kurrosetra/FDI/PCB/LRT_arduino_v2a.brd

## EAGLE design PCB/LRT_arduino_v2a.brd (2020-02-21)

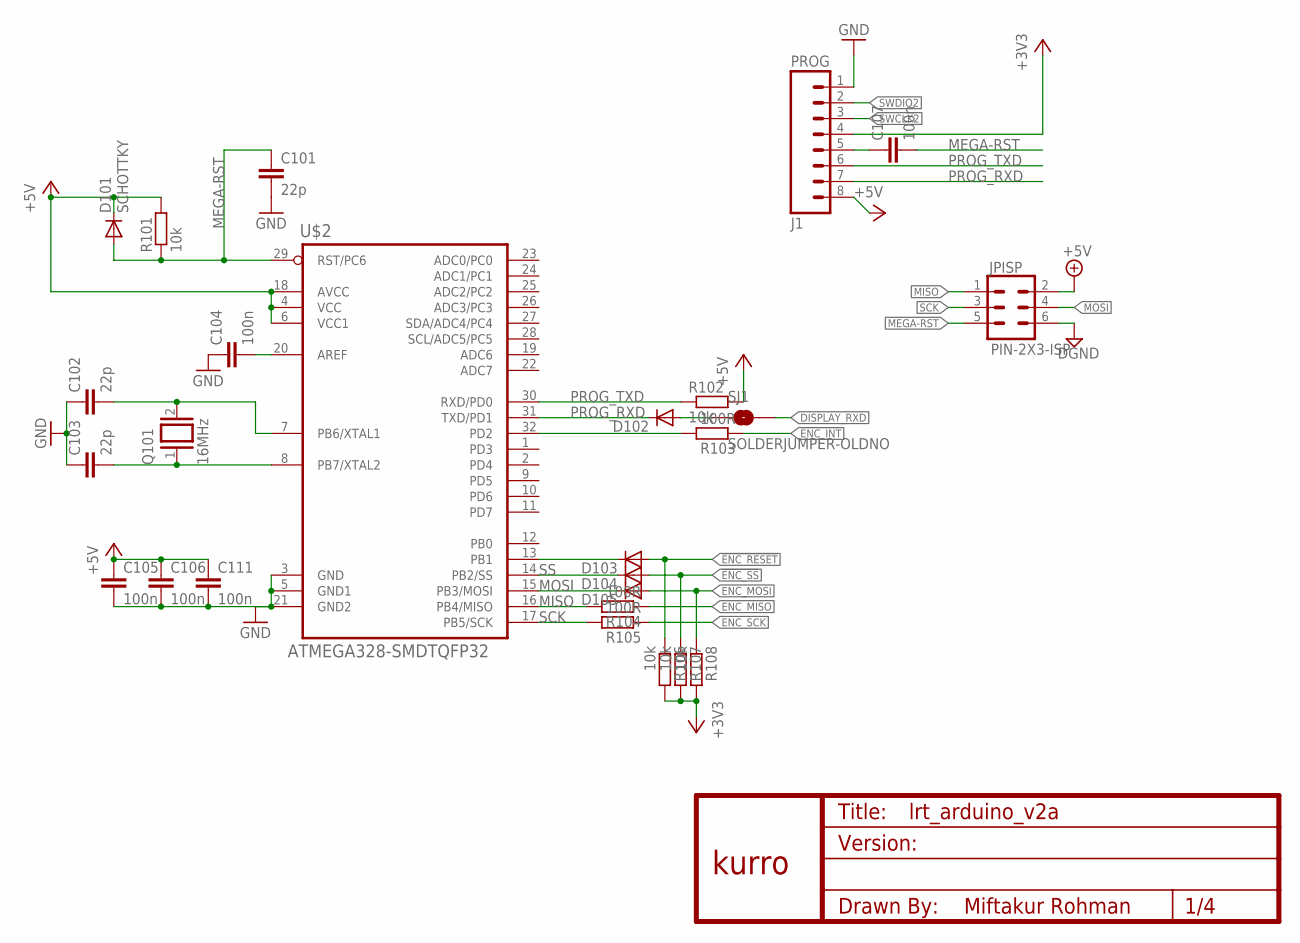
[picture p1: schematic LRT_arduino_v2a.sch, sheet 1, MAIN CONTROLLER]

Parts:
C101, C102, C103: 22p; C0603
C104, C105, C106, C107, C111: 100n; C0603
D101: SCHOTTKY; MICROMELF-W
D102, D103, D104, D105: DIODE-MICROMELF-W; MICROMELF-W
J1: PROG; XH-8-RA
JPISP: PIN-2X3-ISP; 2X03
Q101: 16MHz; QS
R101, R102, R106, R107, R108: 10k; R0603
R103, R104, R105: 100R; R0603
SJ1: SOLDERJUMPER-OLDNO; SJ_2S-NO
U$1: KURRO_FOOTPRINT; KURRO-LOGO
U$2: ATMEGA328-SMDTQFP32; TQFP32

Connections:
!ENC_INT: R103.1; also elsewhere on the board
!ENC_RESET: D103.A, R106.1; also elsewhere on the board
!ENC_SS: D104.A, R107.1; also elsewhere on the board
+3V3: J1.4, R106.2, R107.2, R108.2; also elsewhere on the board
+5V: C105.1, C106.1, C111.1, D101.C, J1.8, JPISP.2, R101.2, R102.2, U$2.4 (VCC), U$2.6 (VCC1), U$2.18 (AVCC); also elsewhere on the board
DISPLAY_RXD: SJ1.2; also elsewhere on the board
ENC_MISO: R104.1; also elsewhere on the board
ENC_MOSI: D105.A, R108.1; also elsewhere on the board
ENC_SCK: R105.1; also elsewhere on the board
GND: C101.2, C102.1, C103.1, C104.1, C105.2, C106.2, C111.2, J1.1, JPISP.6, U$2.3 (GND), U$2.5 (GND1), U$2.21 (GND2); also elsewhere on the board
MEGA-RST: C101.1, C107.2, D101.A, JPISP.5, R101.1, U$2.29 (RST/PC6)
MISO: JPISP.1, R104.2, U$2.16 (PB4/MISO)
MOSI: D105.C, JPISP.4, U$2.15 (PB3/MOSI)
unnamed: C104.2, U$2.20 (AREF)
unnamed: C103.2, Q101.1, U$2.8 (PB7/XTAL2)
unnamed: C102.2, Q101.2, U$2.7 (PB6/XTAL1)
unnamed: R103.2, U$2.32 (PD2)
unnamed: C107.1, J1.5
unnamed: D103.C, U$2.13 (PB1)
unnamed: D102.A, SJ1.1
PROG_RXD: D102.C, J1.7, U$2.31 (TXD/PD1)
PROG_TXD: J1.6, R102.1, U$2.30 (RXD/PD0)
SCK: JPISP.3, R105.2, U$2.17 (PB5/SCK)
SS: D104.C, U$2.14 (PB2/SS)
SWCLK2: J1.3; also elsewhere on the board
SWDIO2: J1.2; also elsewhere on the board

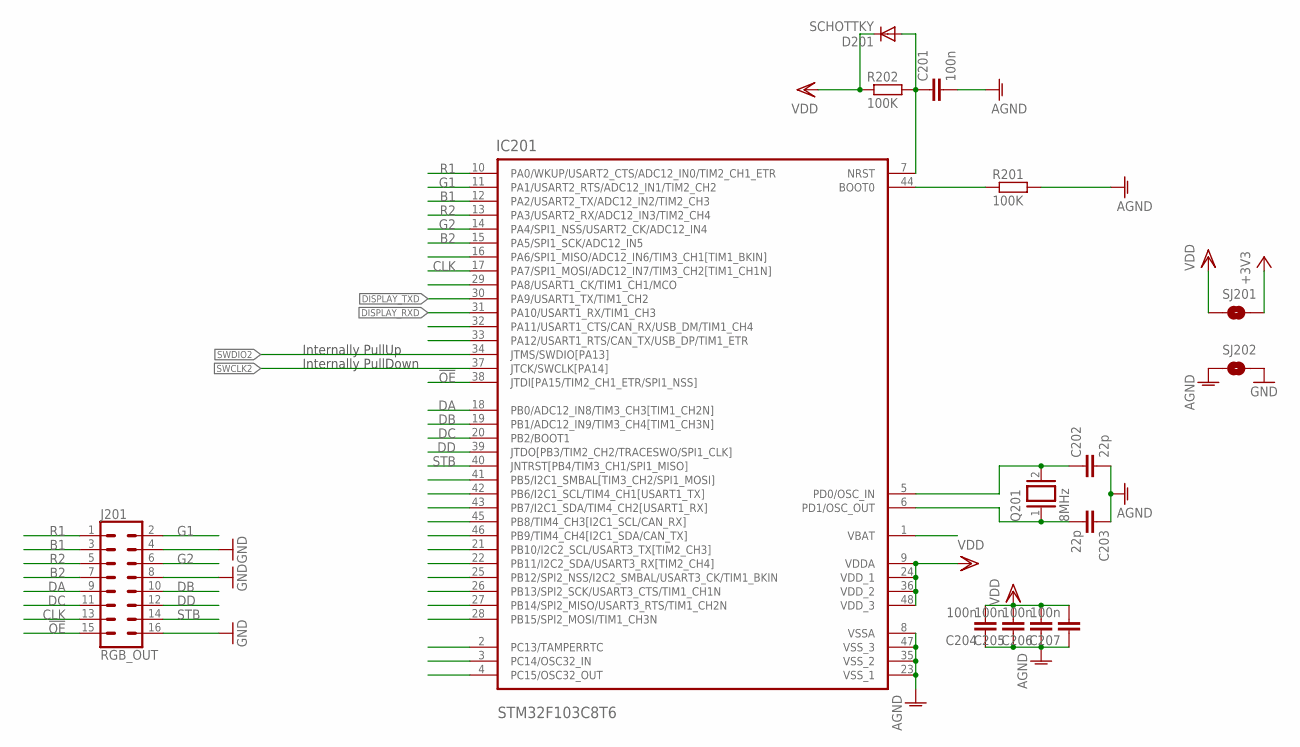
[picture p2: schematic LRT_arduino_v2a.sch, sheet 2, DISPLAY_CONTROLLER]

Parts:
C201, C204, C205, C206, C207: 100n; C0603
C202, C203: 22p; C0603
D201: SCHOTTKY; MICROMELF-W
IC201: STM32F103C8T6; QFP50P900X900X160-48N
J201: RGB_OUT; 2X08-LOCK
Q201: 8MHz; QS
R201, R202: 100K; R0603
SJ201, SJ202: SOLDERJUMPERTRACE; SJ_2S-TRACE

Connections:
!OE: IC201.38 (JTDI[PA15/TIM2_CH1_ETR/SPI1_NSS]), J201.15
+3V3: SJ201.2; also elsewhere on the board
AGND: C201.2, C202.2, C203.1, C204.1, C205.1, C206.1, C207.1, IC201.8 (VSSA), IC201.23 (VSS_1), IC201.35 (VSS_2), IC201.47 (VSS_3), R201.2, SJ202.1
B1: IC201.12 (PA2/USART2_TX/ADC12_IN2/TIM2_CH3), J201.3
B2: IC201.15 (PA5/SPI1_SCK/ADC12_IN5), J201.7
BOOT0: IC201.44 (BOOT0), R201.1
CLK: IC201.17 (PA7/SPI1_MOSI/ADC12_IN7/TIM3_CH2[TIM1_C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), J201.13
DA: IC201.18 (PB0/ADC12_IN8/TIM3_CH3[TIM1_CH2N]), J201.9
DB: IC201.19 (PB1/ADC12_IN9/TIM3_CH4[TIM1_CH3N]), J201.10
DC: IC201.20 (PB2/BOOT1), J201.11
DD: IC201.39 (JTDO[PB3/TIM2_CH2/TRACESWO/SPI1_CLK]), J201.12
DISPLAY_RXD: IC201.31 (PA10/USART1_RX/TIM1_CH3); also elsewhere on the board
DISPLAY_TXD: IC201.30 (PA9/USART1_TX/TIM1_CH2)
G1: IC201.11 (PA1/USART2_RTS/ADC12_IN1/TIM2_CH2), J201.2
G2: IC201.14 (PA4/SPI1_NSS/USART2_CK/ADC12_IN4), J201.6
GND: J201.4, J201.8, J201.16, SJ202.2; also elsewhere on the board
unnamed: C203.2, IC201.6 (PD1/OSC_OUT), Q201.1
unnamed: C202.1, IC201.5 (PD0/OSC_IN), Q201.2
R1: IC201.10 (PA0/WKUP/USART2_CTS/ADC12_IN0/TIM2_CH1_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), J201.1
R2: IC201.13 (PA3/USART2_RX/ADC12_IN3/TIM2_CH4), J201.5
RST: C201.1, D201.A, IC201.7 (NRST), R202.2
STB: IC201.40 (JNTRST[PB4/TIM3_CH1/SPI1_MISO]), J201.14
SWCLK2: IC201.37 (JTCK/SWCLK[PA14]); also elsewhere on the board
SWDIO2: IC201.34 (JTMS/SWDIO[PA13]); also elsewhere on the board
VDD: C204.2, C205.2, C206.2, C207.2, D201.C, IC201.9 (VDDA), IC201.24 (VDD_1), IC201.36 (VDD_2), IC201.48 (VDD_3), R202.1, SJ201.1

Notes on the sheet:
Internally PullUp
Internally PullDown

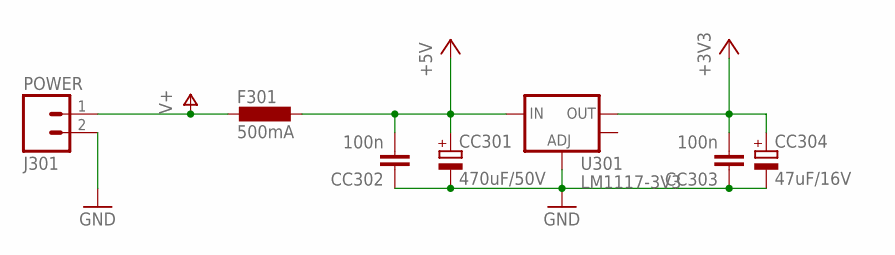
[picture p3: schematic LRT_arduino_v2a.sch, sheet 3, PSU]

Parts:
CC301: 470uF/50V; E2-5
CC302, CC303: 100n; C0603
CC304: 47uF/16V; E2-5
F301: 500mA; L0805
J301: POWER; XH-2-RA
U301: LM1117-3V3; SOT223

Connections:
+3V3: CC303.2, CC304.+, U301.2 (OUT); also elsewhere on the board
+5V: CC301.+, CC302.2, F301.1, U301.3 (IN); also elsewhere on the board
GND: CC301.-, CC302.1, CC303.1, CC304.-, J301.2, U301.1 (ADJ); also elsewhere on the board
V+: F301.2, J301.1

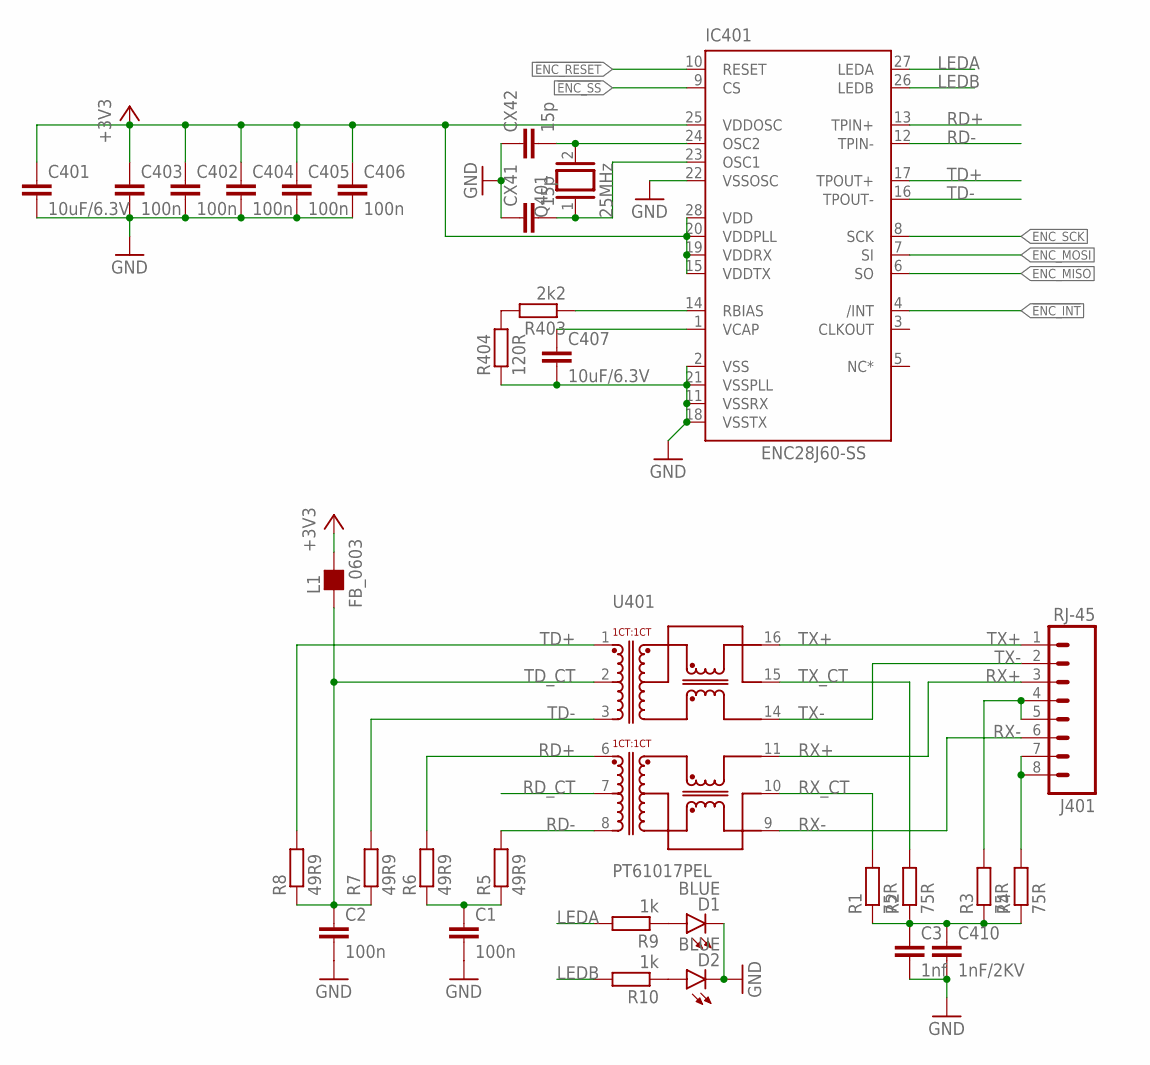
[picture p4: schematic LRT_arduino_v2a.sch, sheet 4, ENC28J60]

Parts:
C1, C2, C402, C403, C404, C405, C406: 100n; C0603
C3: 1nf; C0603
C401, C407: 10uF/6.3V; C0805
C410: 1nF/2KV; C050-055X075
CX41, CX42: 15p; C0603
D1, D2: BLUE; LED-1206
IC401: ENC28J60-SS; SS28
J401: RJ-45; XH-8-RA
L1: FB_0603; L0603
Q401: 25MHz; QS
R1, R2, R3, R4: 75R; R0603
R5, R6, R7, R8: 49R9; R0603
R9, R10: 1k; R0603
R403: 2k2; R0603
R404: 120R; R0603
U401: PT61017PEL; PT61017

Connections:
!ENC_INT: IC401.4 (/INT); also elsewhere on the board
!ENC_RESET: IC401.10 (RESET); also elsewhere on the board
!ENC_SS: IC401.9 (CS); also elsewhere on the board
+3V3: C401.1, C402.1, C403.1, C404.1, C405.1, C406.1, IC401.15 (VDDTX), IC401.19 (VDDRX), IC401.20 (VDDPLL), IC401.25 (VDDOSC), IC401.28 (VDD), L1.2; also elsewhere on the board
ENC_MISO: IC401.6 (SO); also elsewhere on the board
ENC_MOSI: IC401.7 (SI); also elsewhere on the board
ENC_SCK: IC401.8 (SCK); also elsewhere on the board
GND: C1.2, C2.2, C3.2, C401.2, C402.2, C403.2, C404.2, C405.2, C406.2, C407.2, C410.2, CX41.1, CX42.1, D1.C, D2.C, IC401.2 (VSS), IC401.11 (VSSRX), IC401.18 (VSSTX), IC401.21 (VSSPLL), IC401.22 (VSSOSC), R404.1; also elsewhere on the board
LEDA: IC401.27 (LEDA), R9.2
LEDB: IC401.26 (LEDB), R10.2
unnamed: D1.A, R9.1
unnamed: D2.A, R10.1
unnamed: C3.1, C410.1, R1.1, R2.1, R3.1, R4.1
unnamed 36: J401.4, J401.5, R3.2; also elsewhere on the board
unnamed: R403.2, R404.2
unnamed: C407.1, IC401.1 (VCAP)
unnamed 44: J401.7, J401.8, R4.2; also elsewhere on the board
unnamed: CX42.2, IC401.24 (OSC2), Q401.2
unnamed: CX41.2, IC401.23 (OSC1), Q401.1
unnamed: C1.1, R5.1, R6.1
unnamed: IC401.14 (RBIAS), R403.1
RD+: IC401.13 (TPIN+), R6.2, U401.6
RD-: IC401.12 (TPIN-), R5.2, U401.8
RD_CT: U401.7
RX+: J401.3, U401.11; also elsewhere on the board
RX-: J401.6, U401.9; also elsewhere on the board
RX_CT: R1.2, U401.10
TD+: IC401.17 (TPOUT+), R8.2, U401.1
TD-: IC401.16 (TPOUT-), R7.2, U401.3
TD_CT: C2.1, L1.1, R7.1, R8.1, U401.2
TX+: J401.1, U401.16; also elsewhere on the board
TX-: J401.2, U401.14; also elsewhere on the board
TX_CT: R2.2, U401.15

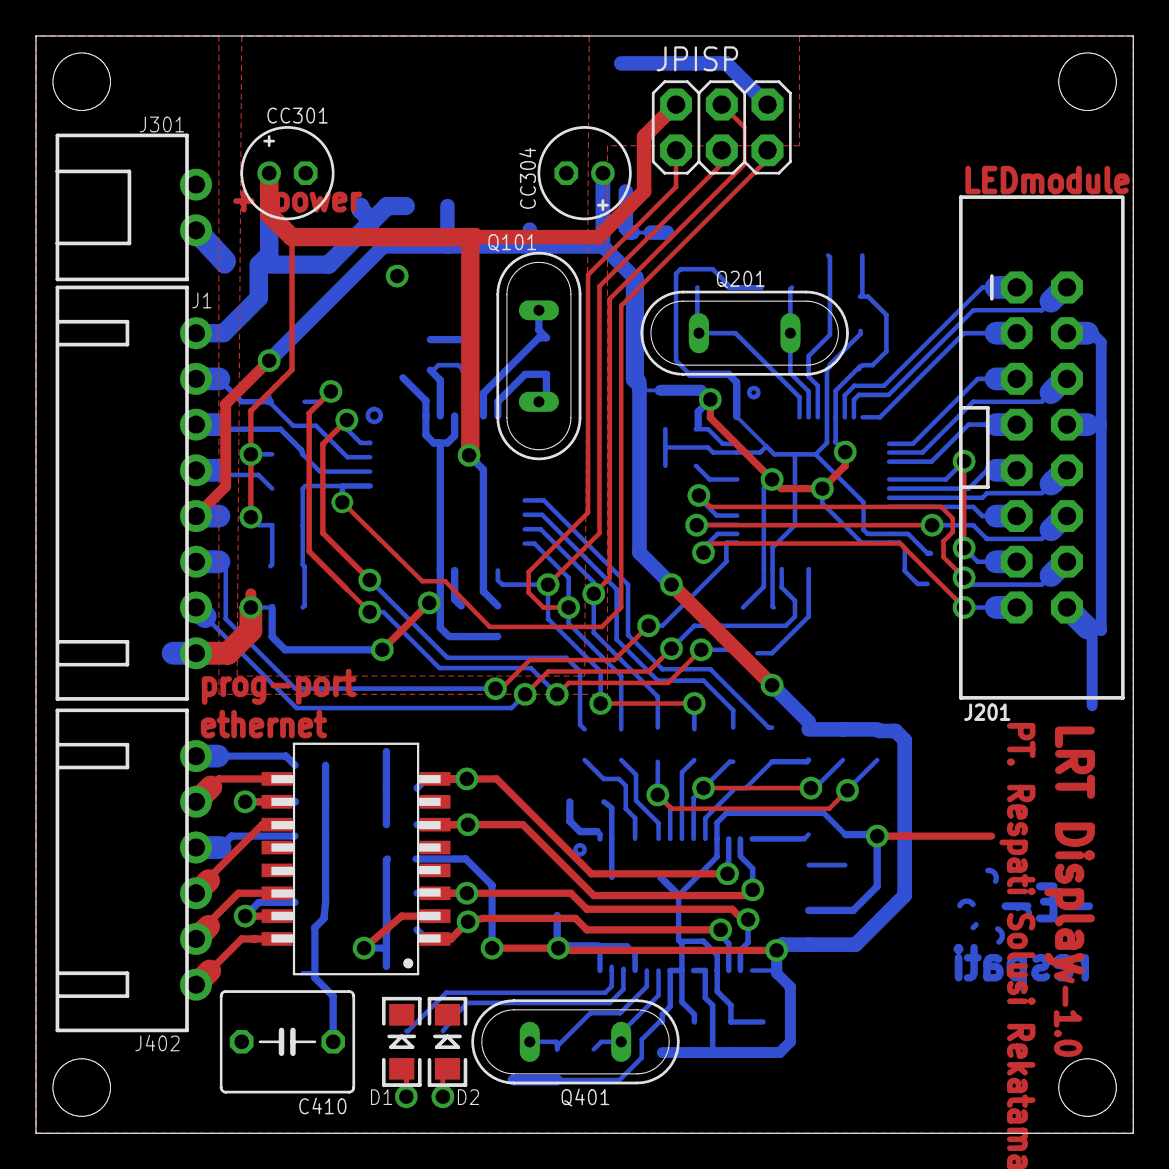
[picture p5: board LRT_arduino_v2a.brd from above]

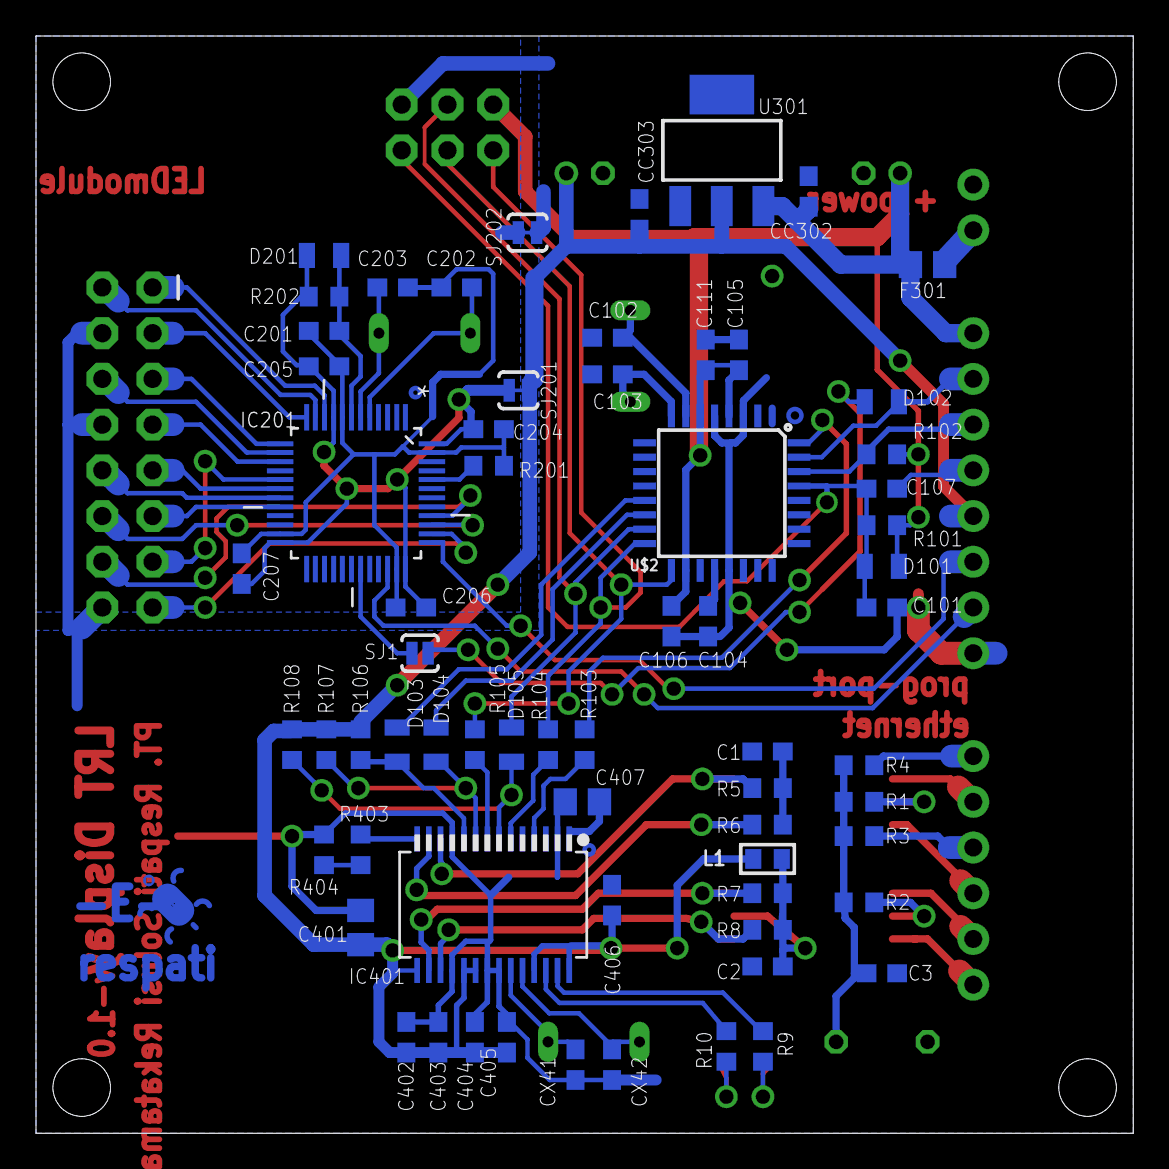
[picture p6: board LRT_arduino_v2a.brd from below]

Board: 2 copper layers, 61.0 x 61.0 mm, 81 parts (66 on the bottom side), 70 nets.

Other parts of the board:
J402: CONN_OUT; XH-6-RA

Their connections:
unnamed 36: J402.4; also elsewhere on the board
unnamed 44: J402.6; also elsewhere on the board
RX+: J402.3; also elsewhere on the board
RX-: J402.5; also elsewhere on the board
TX+: J402.1; also elsewhere on the board
TX-: J402.2; also elsewhere on the board
