kurrosetra/FDI/firmware/LRT/LRT.ioc

Mcu.UserName=STM32F103C8Tx
PA0-WKUP.GPIO_Label=r1
PA0-WKUP.Signal=GPIO_Output
PA1.GPIO_Label=g1
PA1.Signal=GPIO_Output
PA10.Signal=USART1_RX
PA13.Signal=SYS_JTMS-SWDIO
PA14.Signal=SYS_JTCK-SWCLK
PA15.GPIO_Label=oe
PA15.Signal=GPIO_Output
PA2.GPIO_Label=b1
PA2.Signal=GPIO_Output
PA3.GPIO_Label=r2
PA3.Signal=GPIO_Output
PA4.GPIO_Label=g2
PA4.Signal=GPIO_Output
PA5.GPIO_Label=b2
PA5.Signal=GPIO_Output
PA7.GPIO_Label=clk
PA7.Signal=GPIO_Output
PA9.Signal=USART1_TX
PB0.GPIO_Label=da
PB0.Signal=GPIO_Output
PB1.GPIO_Label=db
PB1.Signal=GPIO_Output
PB2.GPIO_Label=dc
PB2.Signal=GPIO_Output
PB3.GPIO_Label=dd
PB3.Signal=GPIO_Output
PB4.GPIO_Label=stb
PB4.Signal=GPIO_Output
PC13-TAMPER-RTC.GPIO_Label=LED_BUILTIN
PC13-TAMPER-RTC.Signal=GPIO_Output
PD0-OSC_IN.Signal=RCC_OSC_IN
PD1-OSC_OUT.Signal=RCC_OSC_OUT
