kurrosetra/FDI/firmware/FDI/matrix/matrix_config.h

/*
 * config.h
 *
 *  Created on: Sep 3, 2018
 *      Author: miftakur
 */

#ifndef MATRIX_CONFIG_H_
#define MATRIX_CONFIG_H_

#include "stm32f1xx.h"
#include "main.h"

#define P8_LOKAL					1
#define P8_IMPORT					2
#define MODULE_USED					P8_IMPORT

#define FRAME_ORIENTATION_1			1
#define FRAME_ORIENTATION_2			2
#define FRAME_ORIENTATION_3			3
#define FRAME_ORIENTATION_4			4

#define MATRIX_SCANROWS_4			4
#define MATRIX_SCANROWS_8			8
#define MATRIX_SCANROWS_16			16

#define FRAME_ORIENTATION			FRAME_ORIENTATION_3
#define MATRIX_SCANROW				MATRIX_SCANROWS_4

#define MATRIX_PANEL_W_NUM			3
#define MATRIX_PANEL_WIDTH			32
#define MATRIX_PANEL_HEIGHT			16

#define MATRIX_MAX_WIDTH			(MATRIX_PANEL_WIDTH * MATRIX_PANEL_W_NUM)
#define MATRIX_MAX_HEIGHT			MATRIX_PANEL_HEIGHT

#define DATA_GPIO					GPIOA
#define CONTROL_GPIO				GPIOB
#define CONTROL_SHIFTER				0
#define CONTROL_BSRR_STB_CLEAR		0x00100000
#define DATA_BSRR_OE_CLEAR			0x80000000
#define DATA_BSRR_CLEAR				0x00FF0000
#define DATA_BSRR_CLK_CLEAR			0x00800000

#if MATRIX_SCANROW==MATRIX_SCANROWS_4
#define FRAME_BUFSIZE				(MATRIX_MAX_WIDTH * 2)
#elif MATRIX_SCANROW==MATRIX_SCANROWS_8
#define FRAME_BUFSIZE				(MATRIX_MAX_WIDTH * 2)
#elif MATRIX_SCANROW==MATRIX_SCANROWS_16
#define FRAME_BUFSIZE				MATRIX_MAX_WIDTH
#endif	//if MATRIX_SCANROW==MATRIX_SCANROWS_8

#define FRAME_SIZE					(FRAME_BUFSIZE * 2)

#define bitRead(value, bit) (((value) >> (bit)) & 0x01)
#define bitSet(value, bit) ((value) |= (1UL << (bit)))
#define bitClear(value, bit) ((value) &= ~(1UL << (bit)))
#define bitWrite(value, bit, bitvalue) (bitvalue ? bitSet(value, bit) : bitClear(value, bit))

#endif /* MATRIX_CONFIG_H_ */
