kurrosetra/FDI/(commit log)

2020-02-21 v1.1.0
    - add initial working firmwares
    - add pcb design
    - add requirement FDI
    [LRT_arduino_v2a.brd, LRT_arduino_v2a.sch]
2020-08-05 update dmu
    changelog:
    - re-format command:
    $RTEXT, TYPE, param1, param2, "text1\ntext2" *
    - add animasi
    [command_format.xlsx]
2020-10-07 Update arduino master
    - ubah fungsi display_setting() di arduino master
    - hotfix display animation
    [command_format.xlsx]
2020-10-09 hotfix
    arduino:
    no eeprom for default_text (TODO next)
    [command_format.xlsx]
